mglagolic-tvz/RUS-remote_controlled_rover/Lab1/slike/ZAJEDNO.png

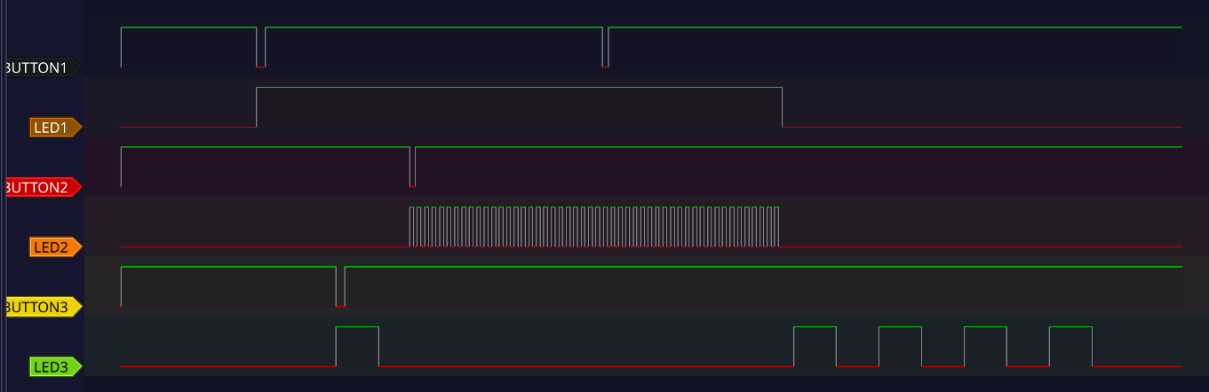
Lab1/slike/ZAJEDNO.png
