mglagolic-tvz/RUS-remote_controlled_rover/README.md

# Rover na daljinsko upravljanje

## Sadržaj
- [Opis projekta](#opis-projekta)
- [Funkcijski zahtjevi](#funkcijski-zahtjevi)
- [Upute za korištenje](#upute-za-korištenje)
- [Poznate greške i ograničenja](#poznate-greške-i-ograničenja)
- [Planovi za budući razvoj](#planovi-za-budući-razvoj)
- [Važne poveznice](#važne-poveznice)
- [Licenca](#licenca)

---

## Opis projekta
Ovaj projekt izrađen je kao projektni zadatak kolegija **Razvoj ugrađenih sustava** na **Tehničkom veleučilištu u Zagrebu**.  
Ideja je izraditi robota na daljinsko upravljanje s prijenosom slike kao hobi maketu, a s vremenom ga razviti u robota za istraživanje nepristupačnih prostora.

Za konstrukciju i pogon robota korištena je platforma s gusjenicama.

U trenutnoj fazi razvoja, robotom se upravlja PlayStation 3 kontrolerom, no protokol komunikacije nije ograničen isključivo na funkcije tog kontrolera. U ovom slučaju, PlayStation 3 kontroler šalje podatke predajniku koji ih prima, prevodi u protokol razumljiv robotu te ih zatim odašilje robotu. Predajnik tako služi kao posrednik u komunikaciji i omogućuje bežični prijenos podataka.

Kao "mozak" robota koristi se **Arduino Nano**. On prima podatke od predajnika, upravlja motorima, očitava stanje baterije te komunicira s kamerom radi uključivanja/isključivanja svjetla i ulaska u "sleep" način rada.

Za funkciju kamere koristi se **ESP32-CAM** s **OV2640** senzorom. ESP32-CAM putem Wi-Fi mreže prenosi video zapis koji se može pregledavati u web pregledniku ili putem media playera koji podržava video streamove (npr. VLC ili mpv).

Korištena varijanta OV2640 senzora opremljena je lećama sa **120° FOV (Field of View)**, što osigurava širu percepciju prostora. Prednji dio robota lagano je vidljiv u kadru, čime se postiže bolji osjećaj dimenzija robota i njegovog odnosa s okolinom.

---

## Fotografija robota
Robot-slika

---

## Funkcijski zahtjevi
| ID  | Funkcijski zahtjev |
|-----|---|
| F1  | Kretanje u prostoru na daljinsko upravljanje. |
| F2  | Baterijsko napajanje. |
| F3  | Bežični prijenos slike putem WiFi-a na pametni telefon ili računalo. |
| F4  | Artikulacijski nosač kamere za neovisno usmjeravanje kamere. |
| F5  | Rasvjetno tijelo za kretanje u mračnim prostorima. |
| F6  | Mjerenje napona baterije. |
| F7  | Standardizirani komunikacijski protokol za podršku različitim tipovima kontrolera (npr. specifični kontroler za rover, PlayStation kontroler, tipkovnica za računalo). |

---

## Upute za korištenje

1. Spojiti predajnik i robota prema [`shemi`](https://github.com/mglagolic-tvz/RUS-remote_controlled_rover/blob/main/sheme/Shema.pdf) u direktoriju (`/sheme`) u ovom repozitoriju.
2. Pomoću Arduino IDE-a snimiti kod iz repozitorija na razvojne pločice (Arduino UNO, Arduino Nano, ESP32-CAM).
3. Priključiti USB Bluetooth dongle na računalo i zabilježiti njegovu MAC adresu.
4. Povezati PlayStation 3 kontroler na računalo USB kablom te pomoću [`SixAxisPairTool`](https://sixaxispairtool.en.lo4d.com/windows) alata usnimiti mu ranije zabilježenu MAC adresu.
5. Na računalu ili mobilnom uređaju otvoriti web preglednik i pristupiti IP adresi ESP32-CAM-a za pregled slike (detaljnije o ovom koraku kasnije u tekstu).
6. Uključiti PlayStation 3 kontroler pritiskom na tipku PS.

**Napomene:**  
- Potrebne knjižnice i firmware opisani su u sekciji [Programska podrška](#programska-podrška).
- Za uspješan upload koda na ESP32-CAM potrebno je instalirati "esp32" (by Espressif Systems) iz Board Managera u Arduino IDE-u.

### Povezivanje računala/mobitela s ESP32-CAM modulom
U kodu za kameru koji se nalazi u repozitoriju (`kodovi/kamera/kamera.ino`) potrebno je izmijeniti varijable SSID i Password tako da odgovaraju Wi-Fi Access Point-u kojim raspolažemo. To može biti Wi-Fi kućna mreža ili HotSpot pametnog telefona. Nakon dodavanja SSID i Password parametara, potrebno je kod usnimiti u ESP32-CAM. Preporuča se ne mijenjati ništa osim SSID i Password parametara jer je lod dosta složen.
Nakon snimanja koda, dok je ESP32-CAM još povezan na računalo putem programatora, ESP32-CAM će u serijsku konzolu ispisati svoju IP adresu koju je dobio od DHCP servera. U praksi ta adresa se rijetko mijenja dokle god je ESP na istoj mreži, no treba imati na umu da se može promijeniti. Ako ne možemo dobiti ping od ESP-a, potrebno ga je isključiti iz robota, spojiti na programator i ponovno u serijskoj konzoli pročitati novu IP adresu. 

**Napomena:** Da bi ESP ispisao svoju IP adresu i ispravno se pokrenuo, korištena Wi-Fi mreža **mora** biti dostupna.

Video prijenosu može se pristupiti na dva načina: 
- Navigiranjem na `<IP_adresa>` bez dodatnih parametara otvara se web sučelje ESP32-CAM modula u kojem se mogu mijenjati parametri kamere te gledati prijenos.
- Navigiranjem na `<IP_adresa>:81/stream` prikazuje se samo prijenos slike bez dodatnih opcija.

U slučaju prekida veze ili gašenja i paljenja robota, nije potrebno ponovo upisivati URL kamere; dovoljno je samo osvježiti web preglednik (stranicu).

### Kontrole PlayStation 3 kontrolera

| Gumb / Palica | Funkcija |
|---|---|
| Lijeva analogna palica | Upravljanje lijevom gusjenicom (naprijed/nazad) |
| Desna analogna palica  | Upravljanje desnom gusjenicom (naprijed/nazad) |
| Strelica gore | Pojačavanje intenziteta svjetla kamere |
| Strelica dolje | Smanjivanje intenziteta svjetla kamere |
| Gumb `R1` | Mijenja funkciju desne palice da upravlja nosačem kamere |
| Desna analogna palica + gumb `R1` | Upravljanje nosačem kamere |

NAPOMENA: Nije moguće u isto vrijeme upravljati gusjenicama i usmjerenjem kamere.

### Razina napunjenosti baterije
Kada robot registrira da je razina baterije pala ispod 20% (<7.4V), signalizirat će to paljenjem LED-ice na predajniku.

### Ulazak u sleep mode
Ako se predajnik ili PlayStation kontroler isključe ili ako robot izgubi vezu s predajnikom, robot nakon isteka vremena od pola sekunde ulazi u sleep mode.  
Sleep mode je implementiran tako da robot gasi kameru (ESP32-CAM ulazi u deep sleep) te isključuje napajanje servo motorima i L293D motor driveru.  
Arduino i HC-12 ostaju budni radi osluškivanja novog signala i buđenja robota.  
Kako ESP32-CAM tijekom prijenosa slike i svaki servo motor samostalno troše više energije nego Arduino Nano i HC-12 zajedno, ovakav način štednje energije dovoljan je da robot ostane uključen nekoliko sati bez značajnog pada razine baterije.

Dugoročni plan je dodati još jedan sleep mode u kojem bi se ugasilo napajanje ESP-u i HC-12, a Arduino Nano bi ušao u sleep s Timer buđenjem nakon određenog vremena.  
Isključivanje regulatora napona za ESP i HC-12 hardverski je već omogućeno. Ovaj pristup teoretski bi omogućio robotu da "spava" danima, no smislen je samo ako robot mora dugo boraviti na nekoj lokaciji. Trenutno, za hobi model, ova funkcionalnost nije potrebna.

---

Za Dodatne informacije o radu ovog robota uputite se na [`Wiki`](https://github.com/mglagolic-tvz/RUS-remote_controlled_rover/wiki) ovoga projekta.

---

## Poznate greške i ograničenja

- Povremeni gubitak komunikacije između HC-12 modula na većim udaljenostima (>50m bez izravne vidljivosti).
- ESP32-CAM može izgubiti Wi-Fi vezu ako signal nije dovoljno jak, što može uzrokovati zastajkivanja u prijenosu slike ili prekid veze.

---

## Planovi za budući razvoj

- Razvoj vlastitog kontrolera za poboljšano upravljanje.
- Za ESP32-CAM isprogramirati da sam pokušava obniviti vezu nakon što pukne signal.
- Koristiti kontrolni zbroj radi poboljšanja integriteta paketa za upravljanje robotom.
- Napuštanje Wi-Fi veze za prijenos slike radi korištenja kvalitetnije tehnologije.
- Korištenje boljih antena.
- Zamjena Arduino Nano s mikrokontrolerom s više pinova i perifernih opcija (trenutno su gotovo svi pinovi iskorišteni, a napredne periferne funkcije poput SPI-ja kolidiraju s PWM izlazom Timer-a 2 korištenim za upravljanje brzinom motora).
- Po potrebi zamijeniti HC-12 s NRF24L01+PA+LNA modulom (kad se oslobodi SPI) ili koristiti oba modula kombinirano.
- Upravljanje PWM frekvencijom radi smanjenja šuma iz DC motora.
- Ugradnja LCD ekrana na predajnik za ispis dijagnostičkih podataka i očitanje razine baterije.
- Implementacija sleep moda robota s periodičkim buđenjem.

---

## Važne poveznice

- [`dokumentacija koda kontrolera robota`](https://mglagolic-tvz.github.io/RUS-remote_controlled_rover/kontroler/).
- [`Dokumentacija koda predajnika`](https://mglagolic-tvz.github.io/RUS-remote_controlled_rover/predajnik/).
- [`Knjižnica PS3BT.h`](https://github.com/felis/USB_Host_Shield_2.0).

## Licenca

Ovaj projekt je objavljen pod GNU General Public License v3.0.
