mglagolic-tvz/RUS-remote_controlled_rover/sheme/popis_komponenti.md

| Naziv | Oznake | Količina |
|---|---|---|
| Battery (li-ion 2S sa zaštitom) | BT1 | 1 |
| LED | D1 | 1 |
| Conn_01x03 | J1, J2 | 2 |
| Screw_Terminal_01x02 | J3, J4 | 2 |
| Arduino_UNO_R3 + USB host Shield  | MOD1 | 1 |
| ESP32-CAM | MOD2 | 1 |
| Arduino_Nano_v3.x | MOD3 | 1 |
| HC-12 | MOD4, MOD5 | 2 |
| Battery_charger (generic module)  | MOD6 | 1 |
| S09_5V | MOD7 | 1 |
| S09_3.3v | MOD8 | 1 |
| Level_shifter (generic module) | MOD9 | 1 |
| R 1k | R1 | 1 |
| R 6.7k | R2, R5 | 2 |
| R 10k | R3, R6, R7 | 3 |
| R 30k | R4 | 1 |
| SW_SPST | SW1 | 1 |
| L293D | U1 | 1 |
| 9g servo motori | | 2 |
| žice | | |
