mglagolic-tvz/RUS-remote_controlled_rover/Prezentacija.pptx

## Robot na daljinsko upravljanje

Projekt iz kolegija Razvoj ugrađenih sustava

Matija Glagolić

## Opis projekta

- Robot na daljinsko upravljanje sa prijenosom slike.
- Zamišljen kao robot za istraživanje nepristupačnih terene no dobro dođe i kao igračka za one koji još nisu odrasli.

## Funkcionalnosti robota

- Pogon – gusjenice
- Baterijsko napajanje
- Bežični prijenos slike
- Usmjeravanje kamere neovisno o platformi robota
- Rasvjeta za kretanje u mraku
- Upravljanje PlayStation kontrolerom, s jednostavnom mogućnošću dodavanja podrške za druge tipove upravljača.

## Komponente

- Arduino UNO
- USB host shield + Bluetooth dongle
- Arduino Nano
- ESP32-CAM
- Servo motori
- Platforma sa gusjenicama
- Artikulacijski nosač kamere
- HC-12 i druge popratne komponente…

## Komunikacija

- ESP32-CAM prenosi sliku putem WiFi veze
- PlayStation kontroler komunicira sa predajnikom pute Bluetooth-a
- Predajnik koristeći PS3BT.h biblioteku dobiva informacije od kontrolera, pakira ih u protokol razumljiv robotu i šalje pomoću HC-12 modula.

## Protokol

- Start i stop bajt
- Parovi ID + vrijednost
- Slanje paketa u intervalima od 100 ms

## Poznate greške i ograničenja

- Kratak domet WiFi veze uzrokuje prekidanje slike i gubitak signala, posebice u zatvorenim prostorima sa preprekama.

## Demonstracija
