mglagolic-tvz/RUS-remote_controlled_rover/Lab1/slike/INT0.png

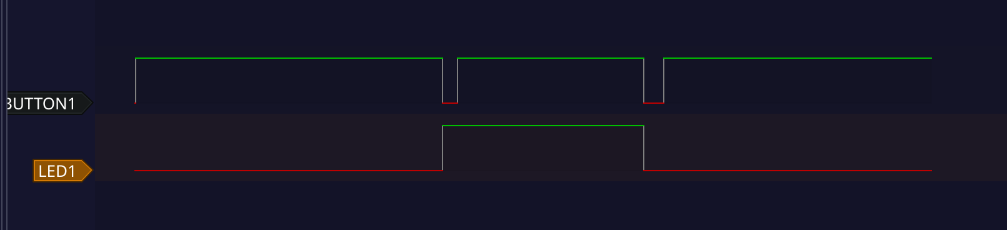
Lab1/slike/INT0.png
