mglagolic-tvz/RUS-remote_controlled_rover/Lab1/slike/INT1.png

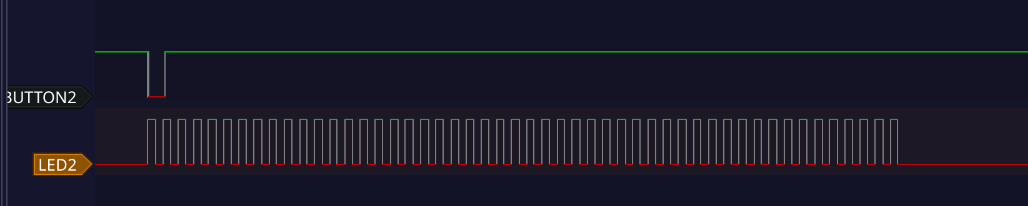
Lab1/slike/INT1.png
