mglagolic-tvz/RUS-remote_controlled_rover/Lab1/slike/INT2.png

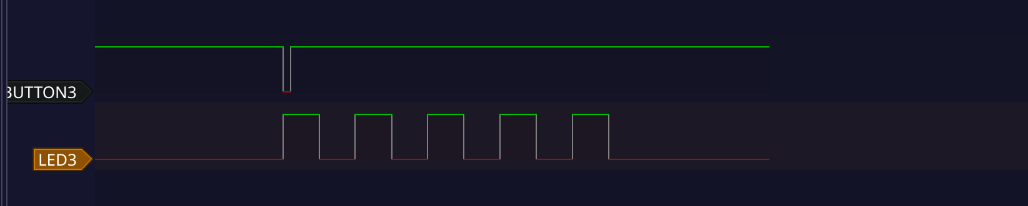
Lab1/slike/INT2.png
