mglagolic-tvz/RUS-remote_controlled_rover/sheme/Shema.pdf

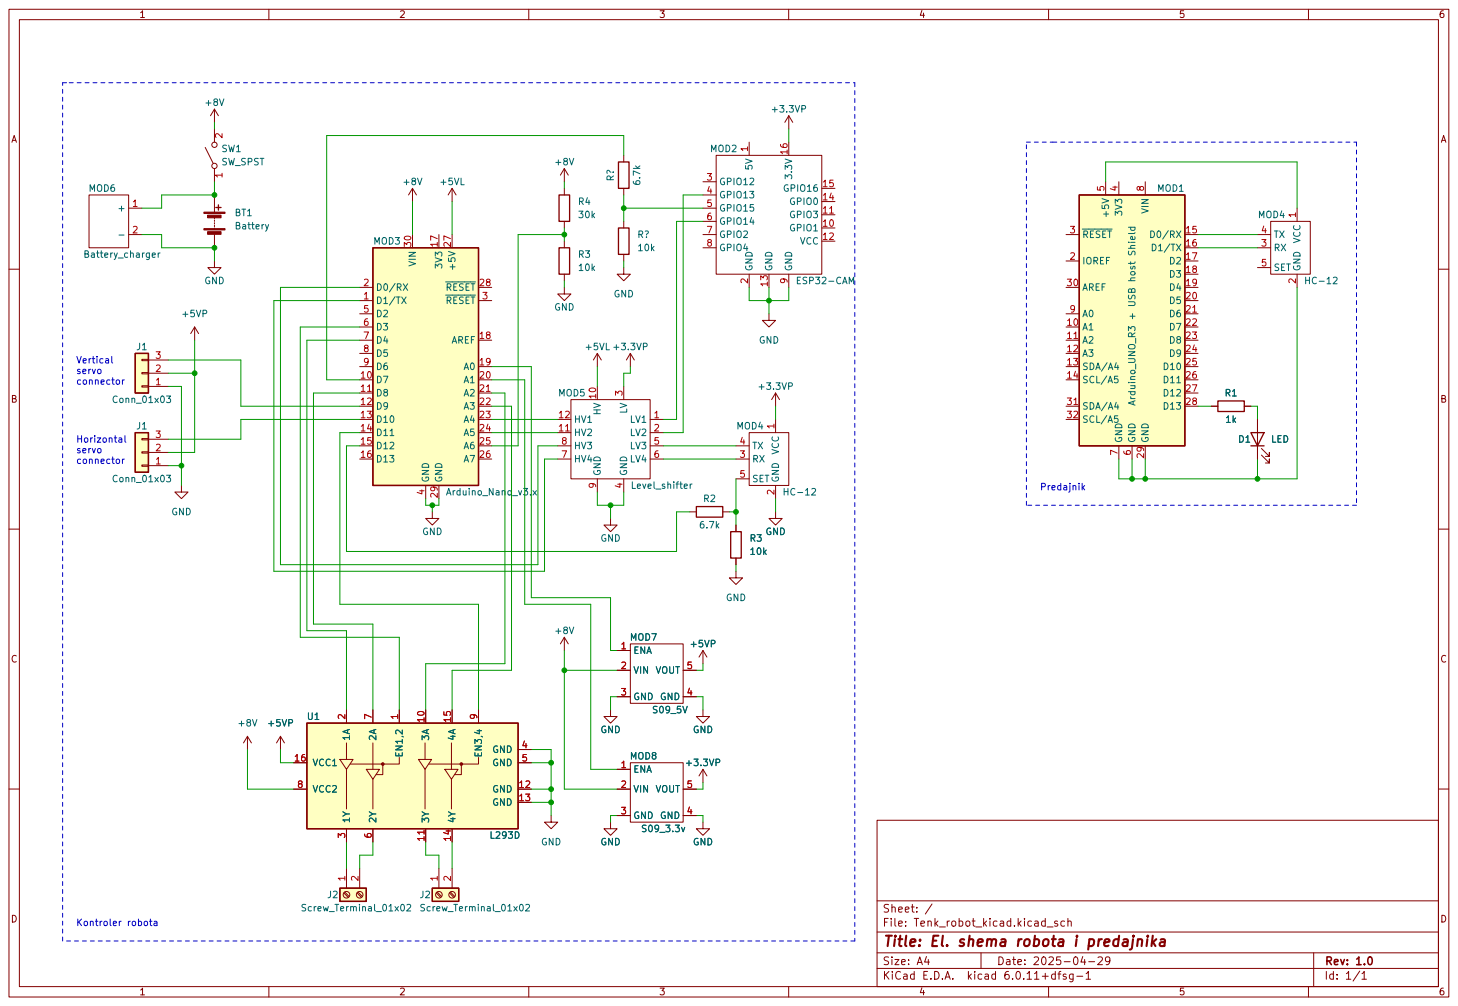
[picture p5: page 1]

Id: 1/1 Title: El. shema robota i predajnika
