mglagolic-tvz/RUS-remote_controlled_rover/kodovi/kontroler_robota/pinovi.h

#define BUCK_5V_ENABLE_PIN A0
#define BUCK_3V_ENABLE_PIN A1

#define HC12_SET_PIN 12

#define MOTOR_1_PWM 3
#define MOTOR_1_A 4
#define MOTOR_1_B 8
#define MOTOR_2_PWM 11
#define MOTOR_2_A A2
#define MOTOR_2_B A3

#define SERVO_H_SIGNAL 10
#define SERVO_V_SIGNAL 9

#define ESP_SLEEP_PIN 7

#define BATTERY_VOLTAGE_PIN A6
