mglagolic-tvz/RUS-remote_controlled_rover/(commit log)

2025-04-03 Create Arduino.ino
    početni file da mogu otvoriti direktorij
2025-04-03 Update Arduino.ino
    Prva verzija, zadovoljen prvi uvjet - LED 1 se uključuje i isključuje pritiskom na tipkalo 1 povezao na vanjski prekid INT0
2025-04-03 Update Arduino.ino
    Dodana blokirajuća ISR te prekid za prekid blokirajuće rutine.
    ISR prekida INT2 je blokirajuća i vrti beskonačnu while petlju. ISR prekida INT 1 postavlja flag koji izbacuje ISR prekida INT2 iz beskonačne while petlje. zajedno Funkcioniraju kao Set i Reset (RS bistabil jer INT1 dominira a on funkcionira kao reset).
    [Arduino.ino]
2025-04-04 Update Arduino.ino
    Promjena ideje zadatka
    odlučio sam da će prekidna rutina prekida INT1 privremeno blokirati rad kontrolera da dokaze da to može omesti millis. Ovu funkcijun još treba implementirati.
    INT0 je dobio debounce mehanizam.
    Timer 1 u zadanom intervalu mijenja intenzitet svijetlosti LED4.
2025-04-04 Update Arduino.ino
    dodan PIR senzor i zvučnik za alarm.
2025-04-04 Update Arduino.ino
    Dodani su komentari
2025-04-04 Update Arduino.ino
    Dodani doxygen komentari
2025-04-04 Update Arduino.ino
    sitni prepravci
2025-04-04 Update Arduino.ino
    Izbrisan greškom postavljeni ispis za debug
2025-04-10 Create Arduino.ino
    Prva verzija Arduino koda
2025-04-10 Update Arduino.ino
    postavljanje prekida prebaceno u setup()
    vise ne deaktiviram prekid, to je bilo radi debounce-a a kako je na ulaz povezan PIR senzor debounce nije potreban.
2025-04-27 Create kamera.ino
    Ovo je prerađen primjer CameraWebServer koji dolazi uz Arduino IDE platformu.
    Ovaj kod stvara web server sa streamom slike sa kamere priključene na esp32-cam modul.
    Primjer CameraWebServer dorađen je tako da je dodana I2C komunikacija koja od slave-a na adresi 0x08 u intervalima od 100ms zahtjeva intenzitet flash led-ice ugrađene u esp32-cam modul.
    Kako bi se ledicu moglo na ovaj način kontrolirati, config objektu kamere dan je drugi timer i kanal kako nebi zauzeo ili ometao rad ledice.
    U planu je dodati ulazak u deep sleep stanje promjenom stanja na gpio 15 pinu te buđenje pomoču prekida promjenom stanja na istom pinu.
2025-04-27 Add files via upload
    Popratne datoteke uz primjer CameraWebServer.
    Jedino odstupanje od originalnog primjera je da je u camera_pins.h za modul AI Thinker ESP32-CAM zakomentiran pin flash ledice kako je web server nebi koristio.
2025-04-27 Create kontroler_robota.ino
    Kod za Arduino nano koji prima komande i upravlja robotom.
    Trenutno je potpuno implementirano:
    - prijam komandi
    - vožnja
    - manipulacija nosačem kamere
    - kontrola intenziteta flash ledice na esp32-cam
2025-04-27 Create predajnik.ino
    Kod predajnika.
    Koristi PlayStation 3 Controller te prevađa u protokol koji robot koristi.
    PlayStation 3 controller povezuje se na predajnik putem usb bluetooth primopredajnika koji je povezan na arduino putem USB host shielda.
    koristi PS3BT biblioteku.
2025-04-28 Update README.md
    Skoro konačna verzija za predaju
    treba jos dodati linkove na el. sheme
2025-04-28 Update pinovi.h
    dodan pin za ocitanje baterije
2025-04-29 Update README.md
    dorada, dodan link na el shemu i PS3BT library u ovom repozitoriju
